azwing/Observatory/doc/Observatory.odt

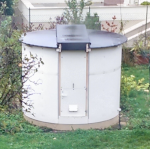
[picture p1: figure]

Figure 1: Top View

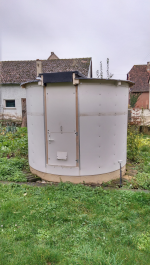
[picture p2: figure]

Figure 2: Front

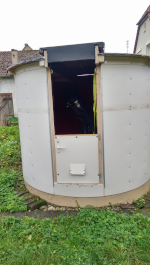
[picture p3: figure]

Figure 3: Top door removed

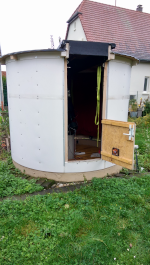
[picture p4: figure]

Figure 4: Door opened

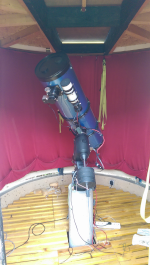
[picture p5: figure]

Figure 5: Telescope

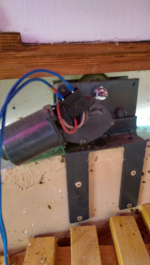
[picture p6: figure]

Figure 6: Rotation Motor

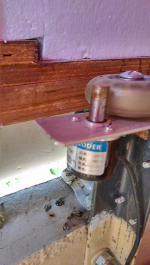
[picture p7: figure]

Figure 7: Rotation Encoder

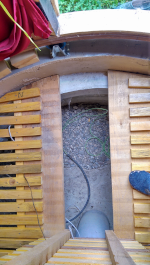
[picture p8: figure]

Figure 8: under the floor

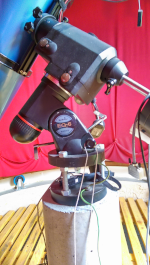
[picture p9: figure]

Figure 9: EQ6 on pier

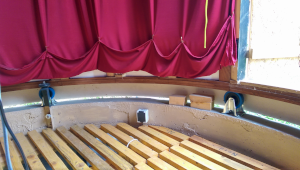
[picture p10: figure]

Figure 10: 2 out of 6 rollers

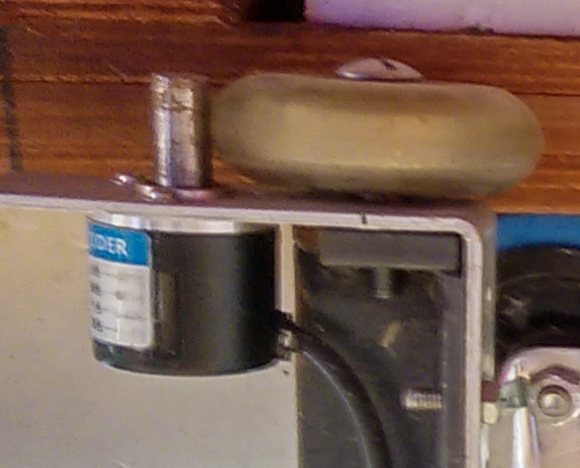
[picture p11: figure]

Figure 11: Encoder detail

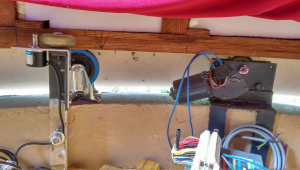
[picture p12: figure]

Figure 12: Encoder, motor and centering wheel

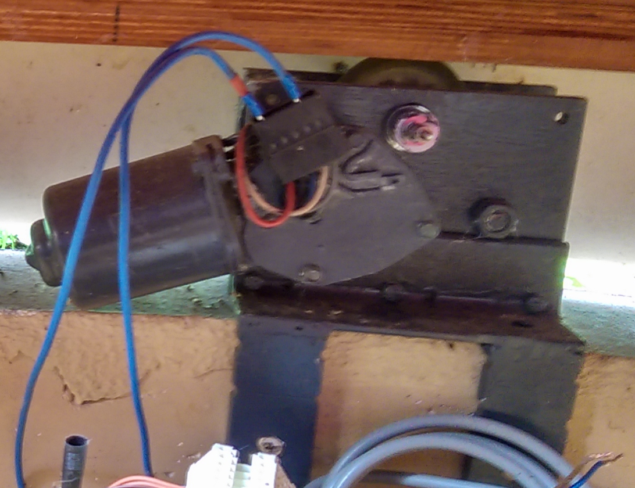
[picture p13: figure]

Figure 13: motor

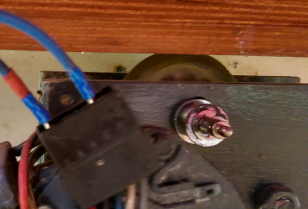
[picture p14: figure]

Figure 14: detail of friction wheel

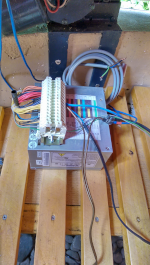
[picture p15: figure]

Figure 15: Modified PC power supply 13,8V

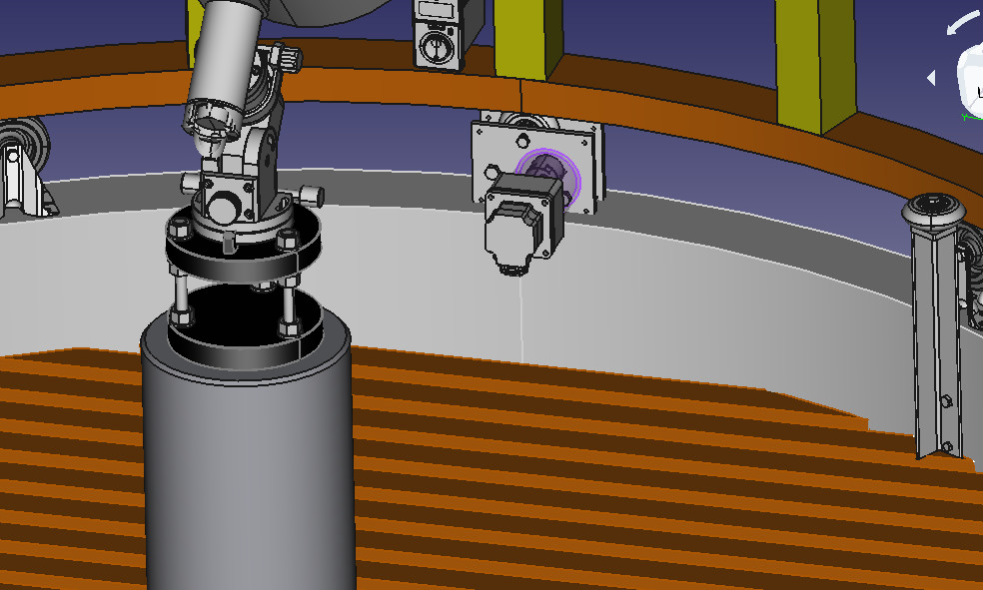
[picture p16: figure]

Figure 16: 3D Cad view
