azwing/Observatory/doc/Observatory.pdf

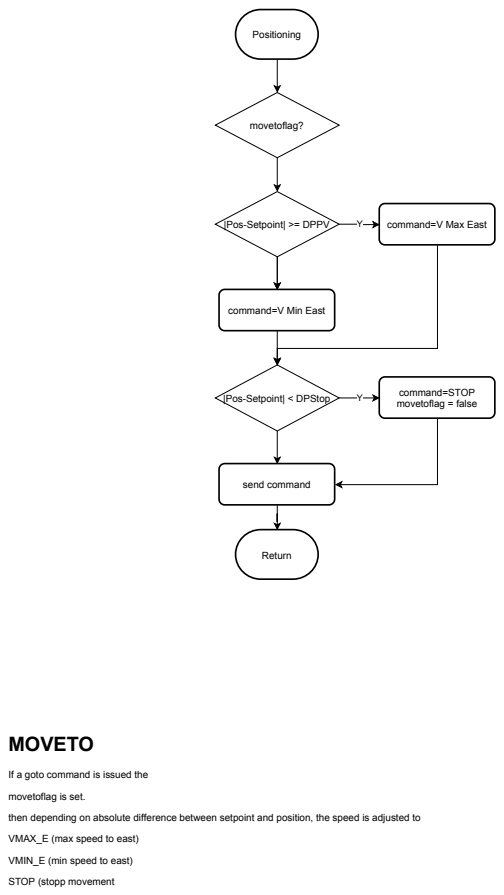
[picture p17: page 1]
Positioning; |Pos-Setpoint| >= DPPV; command=V Max East; |Pos-Setpoint| < DPStop; command=STOP; movetoflag = false Y; send command; Return; movetoflag?; MOVETO

command=V Min East

If a goto command is issued the

movetoflag is set.

then depending on absolute difference between setpoint and position, the speed is adjusted to

VMAX_E (max speed to east)

VMIN_E (min speed to east)

STOP (stopp movement

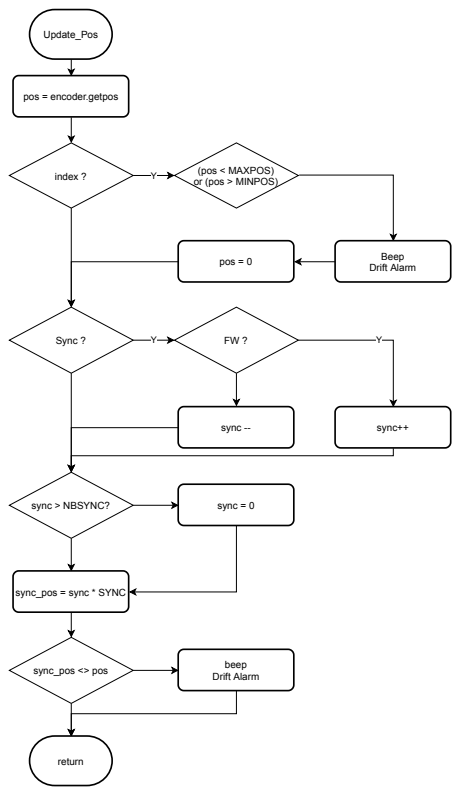
[picture p18: page 2]
Update_Pos; index ?; Beep; Sync ?; sync --; sync++; sync > NBSYNC?; sync = 0; sync_pos = sync * SYNC; sync_pos <> pos; beep; Drift Alarm; return

pos = encoder.getpos

(pos < MAXPOS)
or (pos > MINPOS)

Drift Alarm pos = 0

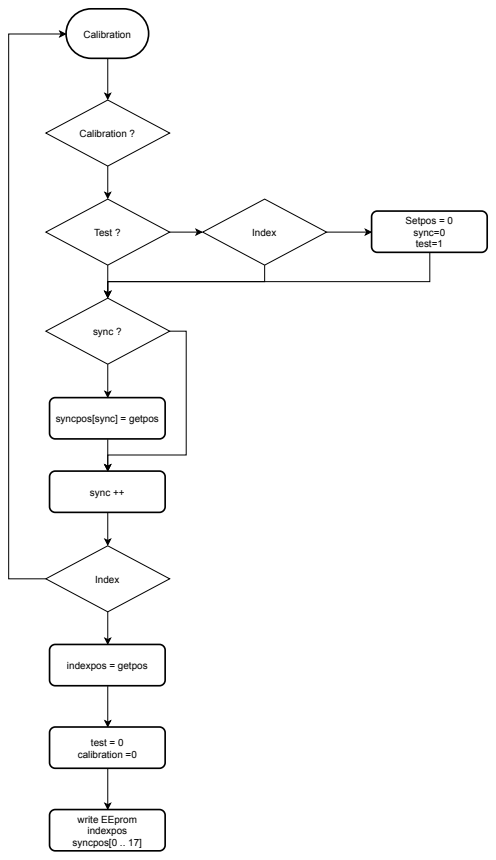
[picture p19: page 3]
Calibration; Calibration ?; Test ?; Index; Setpos = 0 sync=0 test=1; sync ?; sync ++; indexpos = getpos; test = 0 calibration =0; write EEprom indexpos syncpos[0 .. 17]

syncpos[sync] = getpos

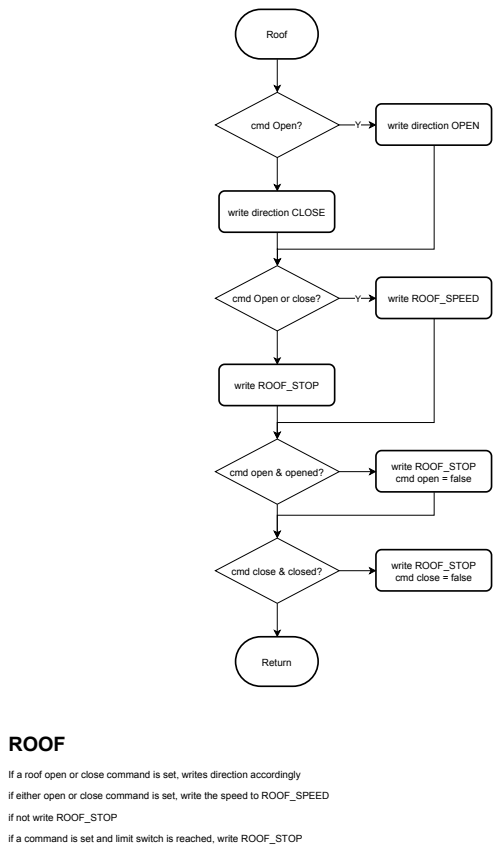
[picture p20: page 4]
Roof; Return; cmd Open?; ROOF; cmd Open or close?; write ROOF_SPEED; write ROOF_STOP

write direction OPEN

write direction CLOSE

cmd open = false cmd open & opened?

cmd close = false cmd close & closed?

If a roof open or close command is set, writes direction accordingly

if either open or close command is set, write the speed to ROOF_SPEED

if not write ROOF_STOP

if a command is set and limit switch is reached, write ROOF_STOP
