azwing/Observatory/doc/Observatory_wiring-diagram.pdf

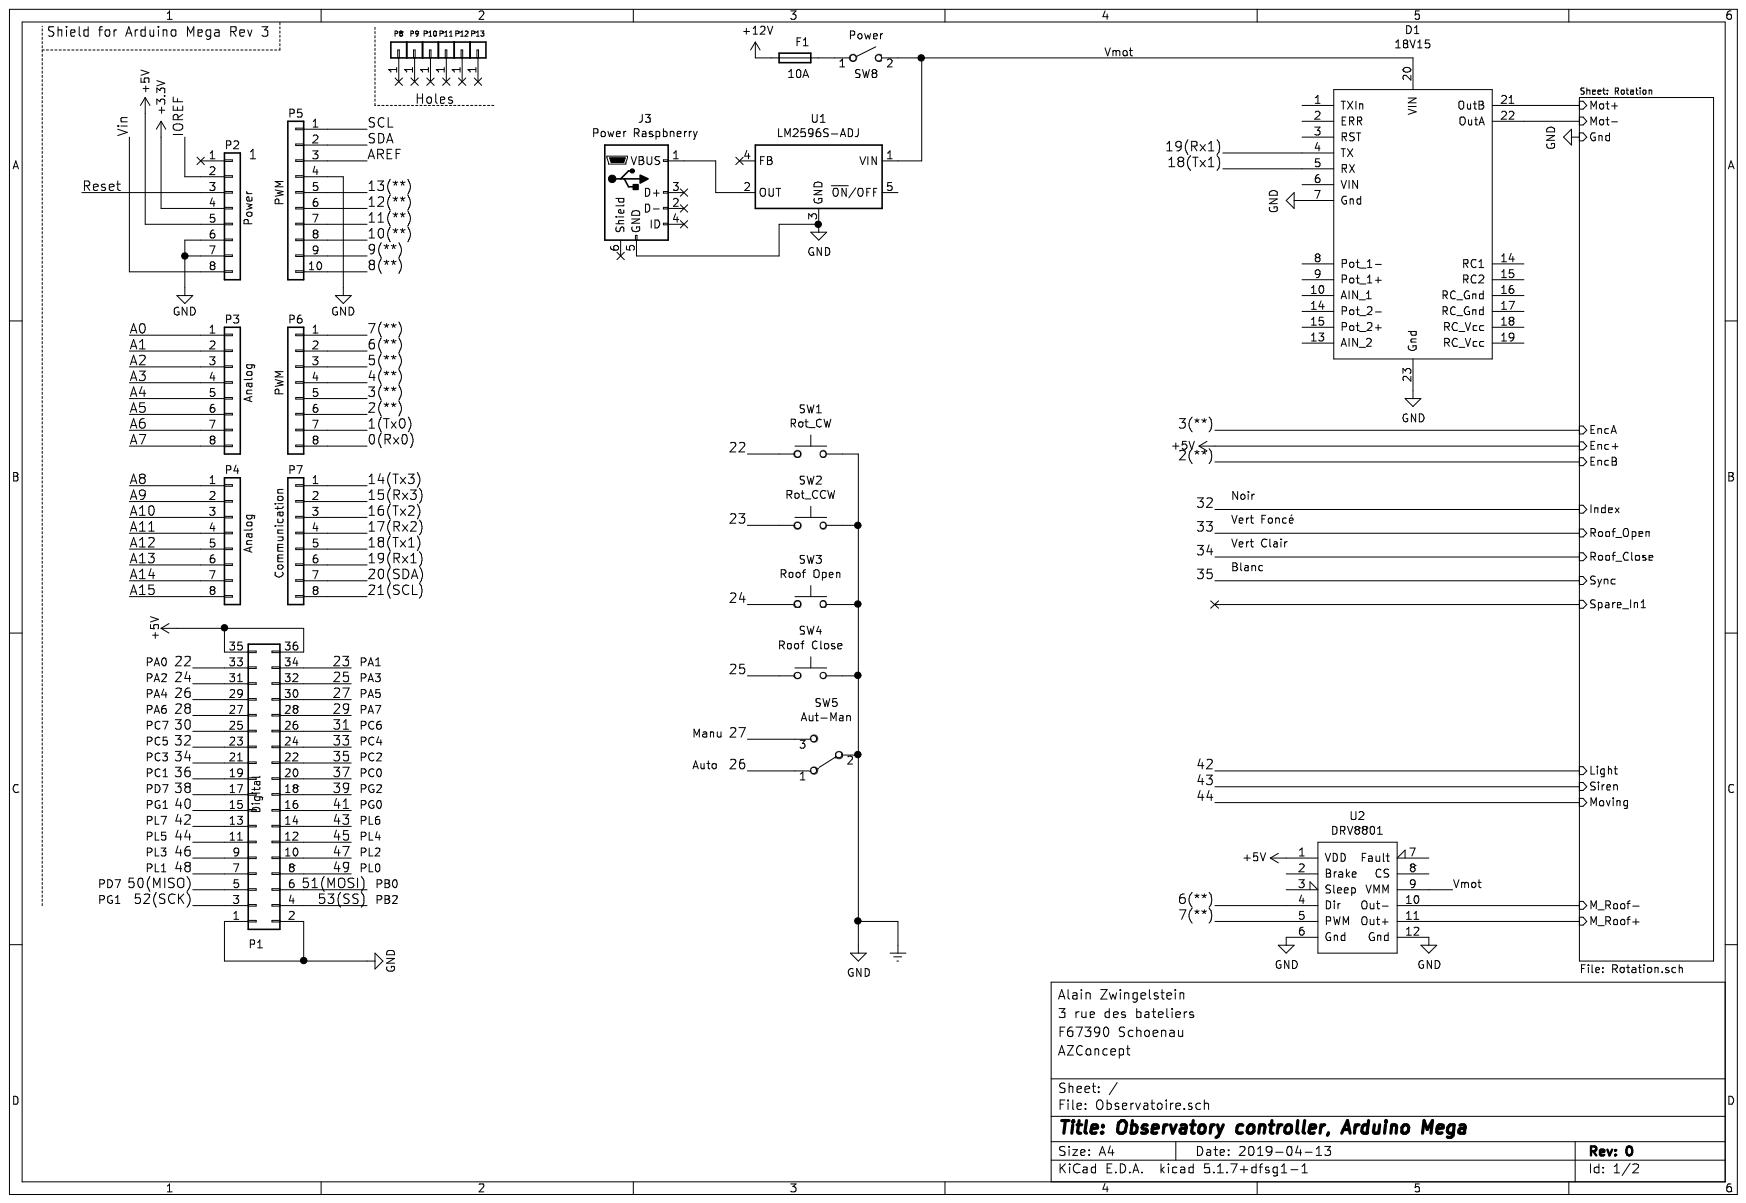
[picture p21: page 1]

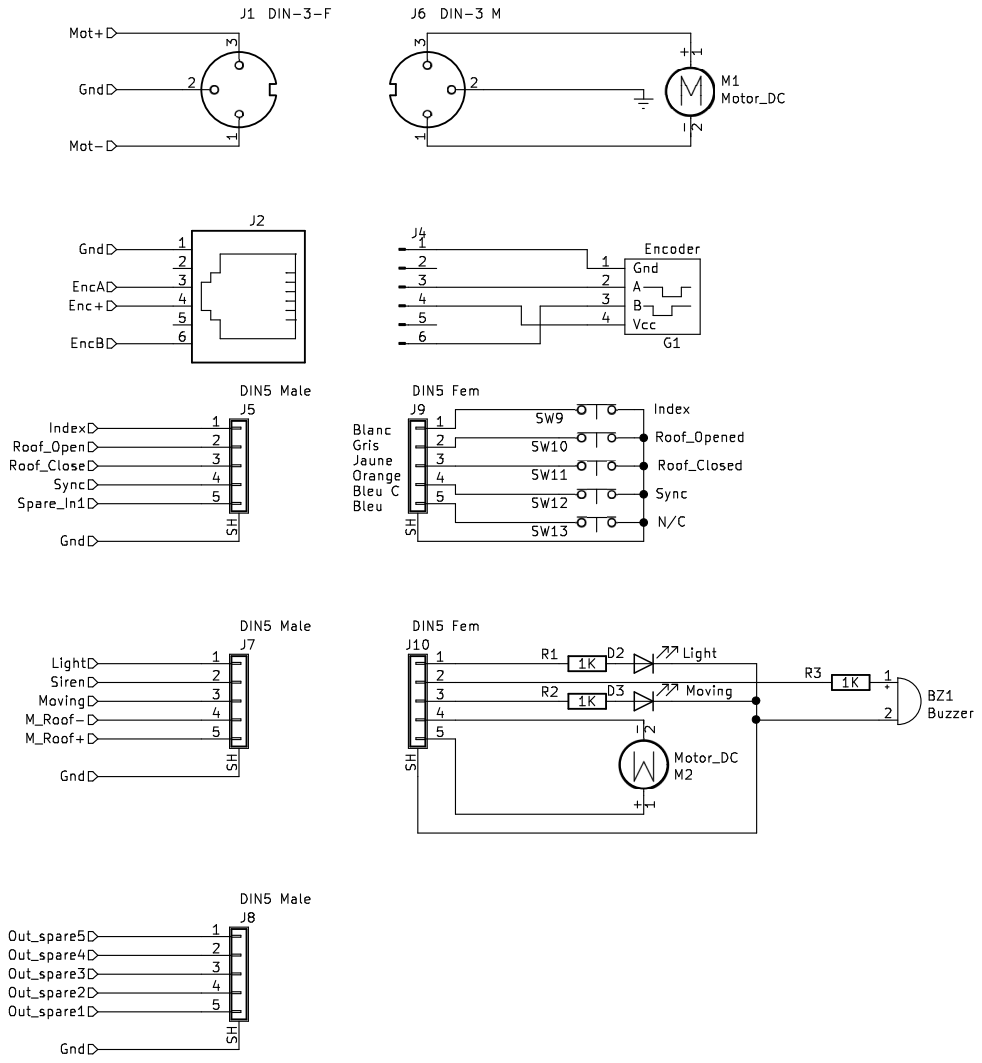
[picture p22: page 2]
