azwing/Observatory/src/HAL/HAL_Mega2560/HAL_Mega2560.h

// Platform setup ------------------------------------------------------------------------------------

// This platform doesn't support true double precision math
#define HAL_NO_DOUBLE_PRECISION

// This is for ~16MHz AVR processors or similar.
#define HAL_SLOW_PROCESSOR

// Set default timer mode unless specified
#ifndef STEP_WAVE_FORM
  #define STEP_WAVE_FORM PULSE
#endif

// Lower limit (fastest) step rate in uS for this platform (in SQW mode)
#define HAL_MAXRATE_LOWER_LIMIT 51.2

// Width of step pulse
#define HAL_PULSE_WIDTH 10000

// New symbols for the Serial ports so they can be remapped if necessary -----------------------------
#ifndef MEGA2560_ARDUINO_SERIAL_ON
  // SerialA is always enabled, SerialB and SerialC are optional
  #define HAL_SERIAL_B_ENABLED     // Enable support for RX1/TX1

  // on a Ramps1.4 board always enable SerialC and default to using Serial2 for it
  #ifdef Ramps14_ON
    #define HAL_SERIAL_C_ENABLED     // Enable support for third serial channel
    #define HAL_SERIAL_C_SERIAL2     // Use RX2/TX2 for channel C (defaults to RX3/TX3 otherwise.)
  #endif
  // this tells OnStep that a .transmit() method needs to be called to send data
  #define HAL_SERIAL_TRANSMIT

  // Use low overhead serial
#include "HAL_Serial.h"
#else
  // New symbols for the Serial ports so they can be remapped if necessary -----------------------------
  #define SerialA Serial
  // SerialA is always enabled, SerialB and SerialC are optional
  #define SerialB Serial1
  #define HAL_SERIAL_B_ENABLED
#endif

// New symbol for the default I2C port -------------------------------------------------------------
#define HAL_Wire Wire

// Non-volatile storage ------------------------------------------------------------------------------
#if defined(NV_AT24C32)
  #ifdef E2END
    #undef E2END
  #endif
  #include "../drivers/NV_I2C_EEPROM_AT24C32.h"
#elif defined(NV_MB85RC256V)
  #ifdef E2END
    #undef E2END
  #endif
  #include "../drivers/NV_I2C_FRAM_MB85RC256V.h"
#else
  #include "../drivers/NV_EEPROM.h"
#endif

// Use an RTC (Real Time Clock) if present -----------------------------------------------------------
// #include "../drivers/RTCw.h"

//--------------------------------------------------------------------------------------------------
// General purpose initialize for HAL
void HAL_Init(void) {
}

//--------------------------------------------------------------------------------------------------
// Internal MCU temperature (in degrees C)
float HAL_MCU_Temperature(void) {
  return -999;
}

//--------------------------------------------------------------------------------------------------
// Initialize timers

// Enable a pseudo low priority level for Timer1 (sidereal clock) so the
// critical motor ISR's don't get delayed by the big slow sidereal clock ISR
#define HAL_USE_NOBLOCK_FOR_TIMER1

extern long int siderealInterval;
extern void SiderealClockSetInterval (long int);

// Init sidereal clock timer
void HAL_Init_Timer_Sidereal() {
  SiderealClockSetInterval(siderealInterval);
}

// Init Axis1 and Axis2 motor timers and set their priorities

// Note the granularity below, these run at 0.5uS per tick with 16bit depth
#define HAL_FIXED_PRESCALE_16BIT_MOTOR_TIMERS

void HAL_Init_Timers_Motor() {
  // ~0 to 0.032 seconds (31 steps per second minimum, granularity of timer is 0.5uS) /8  pre-scaler
  TCCR3B = (1 << WGM12) | (1 << CS11);
  TCCR3A = 0;
  TIMSK3 = (1 << OCIE3A);

  // ~0 to 0.032 seconds (31 steps per second minimum, granularity of timer is 0.5uS) /8  pre-scaler
  TCCR4B = (1 << WGM12) | (1 << CS11);
  TCCR4A = 0;
  TIMSK4 = (1 << OCIE4A);
}

//--------------------------------------------------------------------------------------------------
// Set timer1 to interval (in microseconds*16), for the 1/100 second sidereal timer

void Timer1SetInterval(long iv, double rateRatio) {
  iv=round(((double)iv)/rateRatio);

  TCCR1B = 0; TCCR1A = 0;
  TIMSK1 = 0;

  // set compare match register to desired timer count:
  if (iv<65536) { TCCR1B |= (1 << CS10); } else {
  iv=iv/8;
  if (iv<65536) { TCCR1B |= (1 << CS11); } else {
  iv=iv/8;
  if (iv<65536) { TCCR1B |= (1 << CS10); TCCR1B |= (1 << CS11); } else {
  iv=iv/4;  
  if (iv<65536) { TCCR1B |= (1 << CS12); } else {
  iv=iv/4;
  if (iv<65536) { TCCR1B |= (1 << CS10); TCCR1B |= (1 << CS12); 
  }}}}}
  
  OCR1A = iv-1;
  // CTC mode
  TCCR1B |= (1 << WGM12);
  // timer compare interrupt enable
  TIMSK1 |= (1 << OCIE1A);
}

//--------------------------------------------------------------------------------------------------
// Quickly reprogram the interval for the motor timers, must work from within the motor ISR timers
// interval (r) is in (in microseconds*2) due to using HAL_FIXED_PRESCALE_16BIT_MOTOR_TIMERS 
// for a maximum period of 0.032 seconds (16 bit, 65535 maximum interval)

#define QuickSetIntervalAxis1(r) (OCR3A=r)
#define QuickSetIntervalAxis2(r) (OCR4A=r)

// --------------------------------------------------------------------------------------------------
// Fast port writing help

#define CLR(x,y) (x&=(~(1<<y)))
#define SET(x,y) (x|=(1<<y))
#define TGL(x,y) (x^=(1<<y))

// We use standard #define's to do **fast** digitalWrite's to the step and dir pins for the Axis1/2 stepper drivers
#define StepPinAxis1_HIGH SET(Axis1StepPORT, Axis1StepBit)
#define StepPinAxis1_LOW CLR(Axis1StepPORT, Axis1StepBit)
#define DirPinAxis1_HIGH SET(Axis1DirPORT, Axis1DirBit)
#define DirPinAxis1_LOW CLR(Axis1DirPORT, Axis1DirBit)

#define StepPinAxis2_HIGH SET(Axis2StepPORT, Axis2StepBit)
#define StepPinAxis2_LOW CLR(Axis2StepPORT, Axis2StepBit)
#define DirPinAxis2_HIGH SET(Axis2DirPORT, Axis2DirBit)
#define DirPinAxis2_LOW CLR(Axis2DirPORT, Axis2DirBit)
